Roboy/myoMotorBoard/PCB-POOL_v3.xlsx

BILL OF MATERIAL WITH BETA STOCK, GROUPED BY VALUES, AS OF 09.10.2015
Part | Value | Device | Package | Description | Description2 | Qty | Place_YES/NO | Povided_by_customer_YES/NO | Distributor | Ordernumber | Weblink | Remarks_customer | Unit_price | Total_price | REMARKS_BETA | OPTION1 | OPTION2 | OPTION3
3V3OK, 5VOK, LED5 | Green | LEDCHIPLED_0603 | CHIPLED_0603 | LED |  | 3 | YES | YES | Farnell | 1716770 | http://de.farnell.com/multicomp/ovs-0603/led-0603-super-bright-blau/dp/1716770?ost=1716770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
C1, C2, C3, C6, C7, C8, C9, C14, C16, C17, C18, C19, C24, C25, C30, C31, C36, C56, C57 | 100n | C-EUC0402K | C0402K | CAPACITOR, European symbol | Keramik Kondensator, 0402, X5R, 16V, 100nF | 19 | YES | NO | Beta | 7235228 | http://de.rs-online.com/web/p/ceramic-multilayer-capacitors/7235228P/?searchTerm=7235228p
C4, C5 | 1nF | C-EUC0402K | C0402K | CAPACITOR, European symbol | Kondensator, 0402, X7R, 50V, 1nF | 2 | YES | NO | Beta | 147566 | http://de.rs-online.com/web/p/keramik-multilayer-kondensatoren/0147566/?searchTerm=147566
C10, C12 | 10uF | C-EUC0805K | C0805K | CAPACITOR, European symbol |  | 2 | YES | YES | Farnell | 2611943 | http://de.farnell.com/murata/grm21br6ya106ke43l/kondensator-mlcc-x5r-10uf-35v/dp/2611943?ost=2611943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
C11, C13, C15 | 1uF | C-EUC0603K | C0603K | CAPACITOR, European symbol | Kondensator, 0603, X5R, 16V, 1µF | 3 | YES | NO | Beta | 6911142 | http://de.rs-online.com/web/p/keramik-multilayer-kondensatoren/6911142/?searchTerm=6911142
C22, C23 | 47pf | C-EUC0402K | C0402K | CAPACITOR, European symbol |  | 2 | YES | YES | Farnell | 1758959 | http://de.farnell.com/multicomp/mc0402n470j500ct/kondensator-mlcc-c0g-np0-47pf/dp/1758959?ost=1758959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
C34, C35 | 2.2uF | C-EUC1210 | C1210 | CAPACITOR, European symbol |  | 2 | YES | YES | Farnell | 2320932 | http://de.farnell.com/multicomp/mc1210b225k250ct/kondensator-mlcc-x7r-2-2uf-25v/dp/2320932?ost=2320932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
C50 | 10uF | CPOL-EUD | PANASONIC_D | POLARIZED CAPACITOR, European symbol |  | 1 | YES | YES | Farnell | 2610905 | http://de.farnell.com/multicomp/mcvvt050m100da1l/kond-alu-elko-10uf-50v-becher/dp/2611394
C51, C52, C53, C54 | 10uF | C-EUC1210 | C1210 | CAPACITOR, European symbol |  | 4 | YES | YES | Farnell | 1828859 | http://de.farnell.com/murata/grm32df51h106za01l/kondensator-mlcc-y5v-10uf-50v/dp/1828859?ost=1828859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
C58, C59 | 22uF | C-EUC1210 | C1210 | CAPACITOR, European symbol |  | 2 | YES | YES | Farnell | 2320935 | http://de.farnell.com/multicomp/mc1210x226k250ct/kondensator-mlcc-x5r-22uf-25v/dp/2320935?ost=2320935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
CON2 | IDC 10 | MICRO_MATCH | MIRCO_MATCH |  |  | 1 | YES | YES | Farnell | 1865137 | http://de.farnell.com/amphenol/tmm-6-l-10-1/buchse-smt-lock-1-27mm-10wege/dp/1865137?ost=1865137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
D1, D2, D3 |  | DIODE_2CACA-SOT23 | SOT23 | 2 Diodes - Cathode-Anode|Cathode-Anode |  | 3 | YES | YES | Farnell | 2432680 | http://de.farnell.com/infineon/bat6404e6327htsa1/gr-diode-schottky-0-12a-40v-sot/dp/2432680?ost=2432680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
D5 | RB060MM-60TFTR | 1N5819HW | SOD123 |  |  | 1 | YES | YES | Farnell | 2666946 | http://de.farnell.com/rohm/rb060mm-60tftr/schottky-gleichr-1fach-60v-sod/dp/2666946?ost=2666946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
DC3 | SP6205EM5 | MIC5219BM5 | SOT23-5 | VOLTAGE REGULATOR |  | 1 | YES | YES | RS-Online | 769-5403P | http://de.rs-online.com/web/p/ldo-spannungsregler/7695403P/ | http://de.farnell.com/exar/sp6205em5-l-3-3/spannungsregler-ldo-0-5a-3-3v/dp/9388338?ost=9388338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
DC5 | MAX5035 | MAX5035 | SOIC8 | MAX5035 |  | 1 | YES | YES | Farnell | 2513951 | http://de.farnell.com/webapp/wcs/stores/servlet/ProductDisplay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
J1 | USB | 47346-0001 | MOLEX_47346-0001 | CONN RCPT 5POS MICRO USB R/A SMD |  | 1 | YES | YES | Farnell | 1568026 | http://de.farnell.com/molex/47346-0001/micro-usb-2-0-buchse-typ-b-smd/dp/1568026?ost=1568026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
J3 | TAG Connect | TC2030-MCP-NL | TC2030-MCP-NL | TAG-CONNECT ICSP ConnectorManufacturer: Tag-Connect |  | 1 | NO
L4, L6, L7 | 0603_FERRITE | 0603_FERRITE | R0603 |  |  | 3 | YES | YES | Farnell | 2443234 | http://de.farnell.com/murata/blm18ag121sh1d/ferritperle-0603-0-18ohm-0-5a/dp/2443234?ost=2443234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
L5 | LPS8045B | LPS8045B-104MRB_SPULE | LPS8045B-104MRB_SPULE |  |  | 1 | YES | YES | Farnell | 2526847 | http://de.farnell.com/coilcraft/lps8045b-104mrb/induktivit-t-geschirmt-100uh-1/dp/2526847?ost=2526847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
LED1 | Yellow | LEDCHIPLED_0603 | CHIPLED_0603 | LED |  | 1 | YES | YES | Farnell | 2099227 | http://de.farnell.com/kingbright/kpt-1608yc/led-gelb-0603-smd/dp/2099227?ost=2099227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
LED4 | Red | LEDCHIPLED_0603 | CHIPLED_0603 | LED |  | 1 | YES | YES | Farnell | 2099221 | http://de.farnell.com/kingbright/kpt-1608ec/led-rot-0603-smd/dp/2099221?ost=2099221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
Q1, Q2, Q3, Q4, Q5, Q6 | SI4456DY | SI4456DY | SO8 |  |  | 6 | YES | YES | Farnell | 1792231 | http://de.farnell.com/vishay/si4456dy-t1-e3/n-channel-mosfet-40v-33a-soic/dp/1792231?ost=1792231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
R1, R2, R3, R4, R5, R6, R16, R17 | 10R | R-EU_R0603 | R0603 | RESISTOR, European symbol | RESISTOR, 0.1W, 1% | 8 | YES | No | Beta | 6979084 | http://uk.rs-online.com/web/search/searchBrowseAction.html?method=getProduct&R=6979084
R7, R8 | 0R01 | R-EU_R2512 | R2512 | RESISTOR, European symbol |  | 2 | YES | YES | Farnell | 9403205 | http://de.farnell.com/yageo-phycomp/pf2512fkf7w0r01l/widerstand-2512-2w-r01-1/dp/9403205?ost=9403205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
R10, R11, R12, R22, R33 | 10k | R-EU_R0402 | R0402 | RESISTOR, European symbol | RESISTOR, 0.1W, 1% | 5 | YES | No | Beta | 618-5832 | http://de.rs-online.com/web/p/products/6185832/?searchTerm=618-5832
R13, R28 | 47k | R-EU_R0402 | R0402 | RESISTOR, European symbol | RESISTOR, 0.0625W, 1% | 2 | YES | No | Beta | 6986764 | http://uk.rs-online.com/web/search/searchBrowseAction.html?method=getProduct&R=6986764
R14, R24 | 100k | R-EU_R0402 | R0402 | RESISTOR, European symbol | RESISTOR, 0.0625W, 1% | 2 | YES | No | Beta | 6986783 | http://uk.rs-online.com/web/search/searchBrowseAction.html?method=getProduct&R=6986783
R18 | 470R | R-EU_R0402 | R0402 | RESISTOR, European symbol | RESISTOR, 0.0625W, 1% | 1 | YES | No | Beta | 6980595 | http://uk.rs-online.com/web/search/searchBrowseAction.html?method=getProduct&R=6980595
R20, R26, R27, R31, R55 | 270R | R-EU_R0402 | R0402 | RESISTOR, European symbol | RESISTOR, 0.1W, 1% | 5 | YES | No | Beta | 618-6481 | http://de.rs-online.com/web/p/products/6186481/?searchTerm=618-6481
R21, R25 | 4k7 | R-EU_R0402 | R0402 | RESISTOR, European symbol | RESISTOR, 0.0625W, 1% | 2 | YES | No | Beta | 6980680 | http://uk.rs-online.com/web/search/searchBrowseAction.html?method=getProduct&R=6980680
R23, R29 | 27R | R-EU_R0402 | R0402 | RESISTOR, European symbol | RESISTOR, 0.1W, 1% | 2 | YES | No | Beta | 698-0494 | http://de.rs-online.com/web/p/products/6980494/?searchTerm=698-0494
R50 | 130k | R-EU_R0402 | R0402 | RESISTOR, European symbol |  | 1 | YES | YES | Farnell | 2668197 | http://de.farnell.com/walsin/wr04x1303ftl/dicksch-widerstand-130k-1-0-0625w/dp/2668197?ost=2668197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
R51 | 1M | R-EU_R0402 | R0402 | RESISTOR, European symbol | RESISTOR, 0.0625W, 1% | 1 | YES | No | Beta | 6186194 | http://de.rs-online.com/web/search/searchBrowseAction.html?method=searchProducts&searchTerm=6186194&x=0&y=0
SW1 | TL3700 | TL3700 | TL3700 |  |  | 1 | YES | YES | Farnell | 1894991 | http://de.farnell.com/e-switch/tl3700af160qg/tactile-switch-spst-20ma-15vdc/dp/1894991?ost=1894991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
SW2 | SMD_SWITCH_127_2 | SMD_SWITCH_127_2 | SMD_SWITCH_127_2 |  |  | 1 | YES | YES | Farnell | 1605473 | http://de.farnell.com/multicomp/mcdhn-02f-v/dipschalter-smd-2polig-6-7mm/dp/1605473?ost=1605473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
TVS | SMBJ33A | TVS-DIODE | DIODE |  |  | 1 | YES | YES | Farnell | 9551069 | http://de.farnell.com/vishay/smbj33a-e3-52/tvs-diode-33v-600w-smb/dp/9551069
U$3 | SN65HVD230 | MCP2551 | 999 |  |  | 1 | YES | YES | Farnell | 1103105
U$4 | DSPIC33FJ128MC802QFN | DSPIC33FJ128MC802QFN | QFN-S28-6X6 |  |  | 1 | YES | YES | Farnell | 1576806 | http://de.farnell.com/microchip/dspic33fj128mc802-i-mm/dsc-16bit-128k-flash-40mips-28qfn/dp/1576806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
U$6 | SG-310 | SG-310 | SG-310 |  |  | 1 | YES | YES | Farnell | 1278055 | http://de.farnell.com/epson/q33310f700156-sg-310scf-8-mhz-c/oszillator-spxo-sg-310scf-8mhz/dp/1278055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 | https://www.digikey.de/products/de?keywords=XC1960CT-ND
U1 | A4931 | A4931 | QFN-28-NEW |  |  | 1 | YES | YES | Farnell | 2057410 | http://de.farnell.com/allegro-microsystems/a4931mettr-t/motor-predriver-3ph-28qfn/dp/2057410?ost=2057410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
U2, U3 | MAX3280E | MAX3280E | SOT23-5L |  |  | 2 | YES | YES | Farnell | 2085152 | http://de.farnell.com/maxim-integrated-products/max3280eauk-t/rs422-rs485-rx-52mbps-5-5v-sot23/dp/2512074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
U4 | FT231XQ | FT231XQ | QFN20 |  |  | 1 | YES | YES | Farnell | 2081330 | http://de.farnell.com/ftdi/ft231xq/i-f-usb2-0-fs-f-l-h-s-uart-20qfn/dp/2081330?ost=2081330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
U5, U6 | AD8207 | AD8207 | SO8 |  |  | 2 | YES | YES | Farnell | 1864673 | http://de.farnell.com/analog-devices/ad8207wbrz/ic-amp-diff-hv-8soic/dp/1864673?ost=1864673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
VAR | VC1206K201R025 | VARISTORCN1206 | CT/CN1206 | VARISTOR |  | 1 | YES | YES | Farnell | 2717738 | http://de.farnell.com/kemet/vc1206k201r025/varistor-aec-q200-mlv-65v-1206/dp/2717738
VIN | WAGO_SMD | WAGO_SMD | WAGO_SMD |  |  | 1 | YES | YES | Farnell | 2102477 | http://de.farnell.com/wago/2060-402-998-404/klemmenblock-smd-2pol-24-18awg/dp/2102477?ost=2102477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
X1 | BM06B-SRSS-TB | BM06B-SRSS-TB | BM06B-SRSS-TB | Disconnectable Crimp style connector, 1.0mm pitch6 contacts |  | 1 | YES | YES | Farnell | 1679131 | http://de.farnell.com/jst-japan-solderless-terminals/bm06b-srss-tb-lf-sn/stecker-oben-eing-6kont/dp/1679131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
X2 | BM03B-SRSS-TB | BM03B-SRSS-TB | BM03B-SRSS-TB | Disconnectable Crimp style connector, 1.0mm pitch3 contacts |  | 1 | YES | YES | Farnell | 1679128 | http://de.farnell.com/jst-japan-solderless-terminals/bm03b-srss-tb-lf-sn/stecker-oben-eing-3kont/dp/1679128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
X4 | BM05B-SRSS-TB | BM05B-SRSS-TB | BM05B-SRSS-TB | Disconnectable Crimp style connector, 1.0mm pitch5 contacts |  | 1 | YES | YES | Farnell | 1679130 | http://de.farnell.com/jst-japan-solderless-terminals/bm05b-srss-tb-lf-sn/stecker-oben-eing-5kont/dp/1679130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
X5 | MKS1650-8 | MKS1650-8 | MKS1650 |  |  | 1 | NO
