Roboy/myoMotorBoard/motor drive 8y_protection.pdf

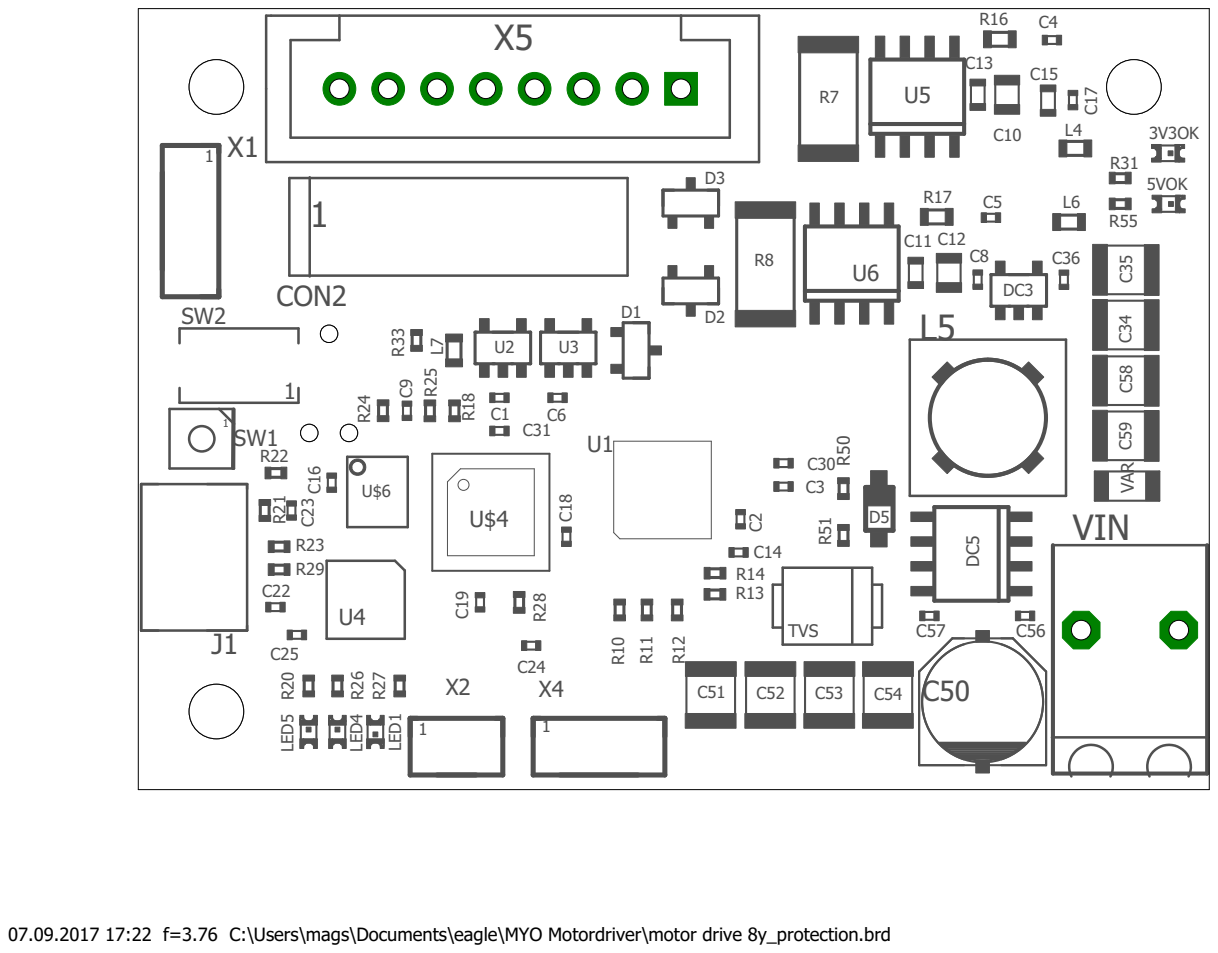
[picture p1: page 1]

07.09.2017 17:22 f=3.76 C:\Users\mags\Documents\eagle\MYO Motordriver\motor drive 8y_protection.brd
