Roboy/myoMotorBoard/motor drive 8y_top.pdf

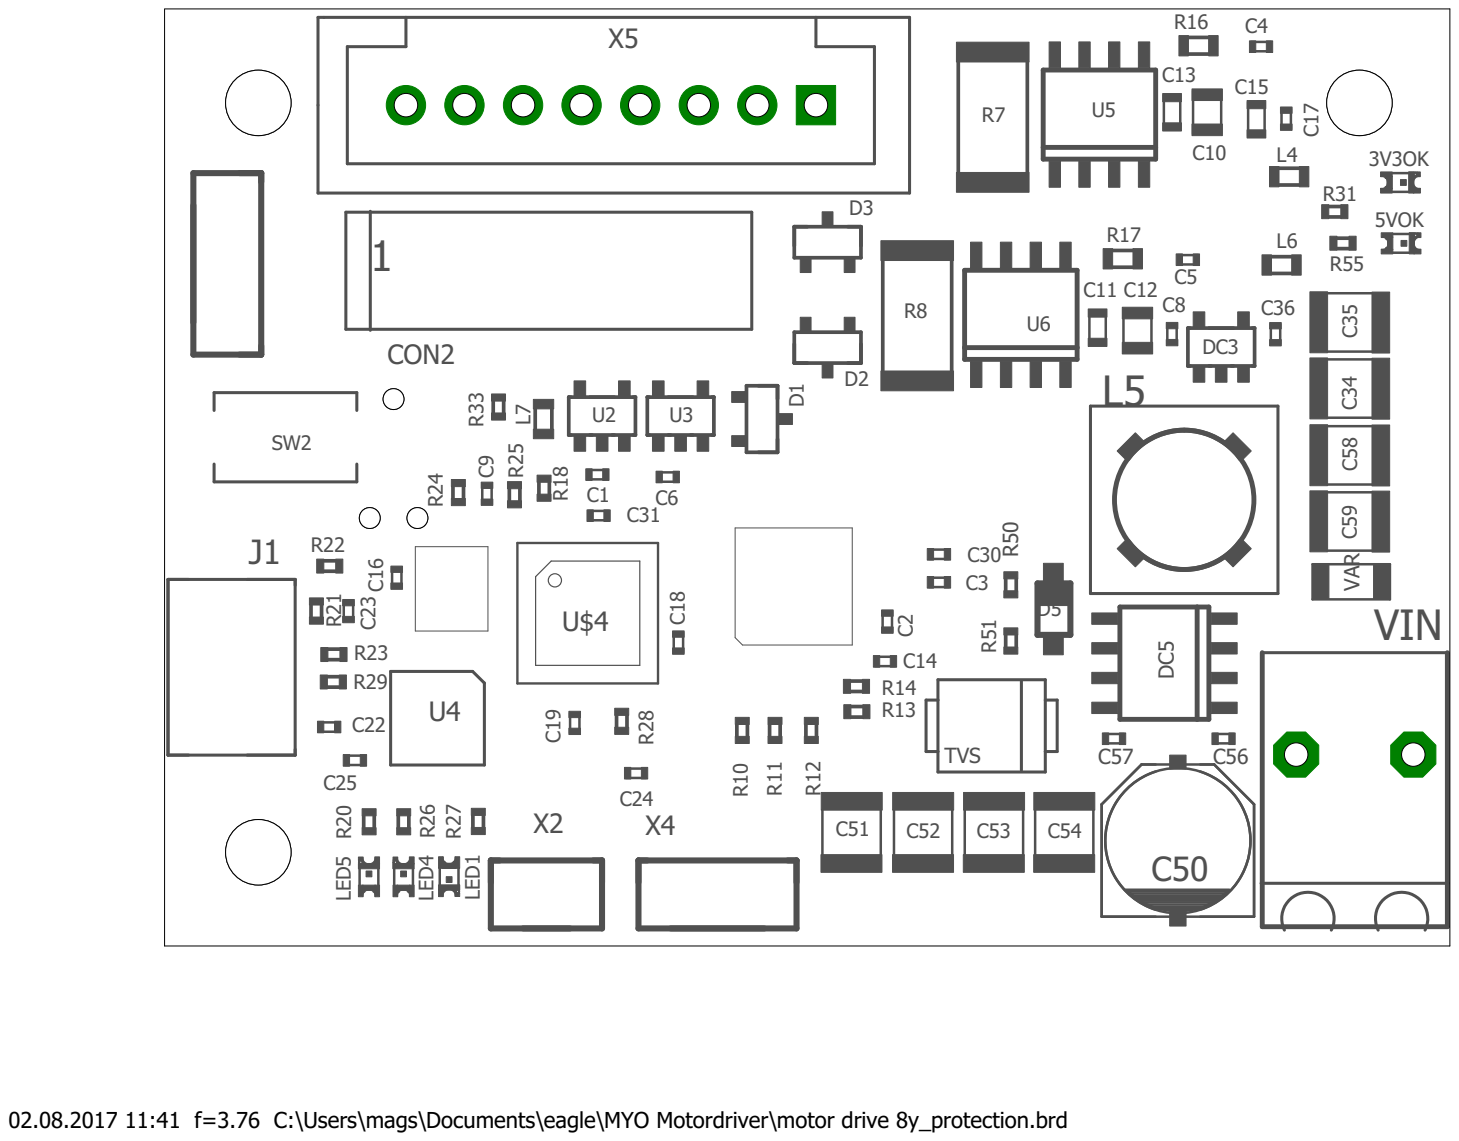
[picture p2: page 1]

02.08.2017 11:41 f=3.76 C:\Users\mags\Documents\eagle\MYO Motordriver\motor drive 8y_protection.brd
