Roboy/myoMotorBoard/motor drive 9y_bottom.pdf

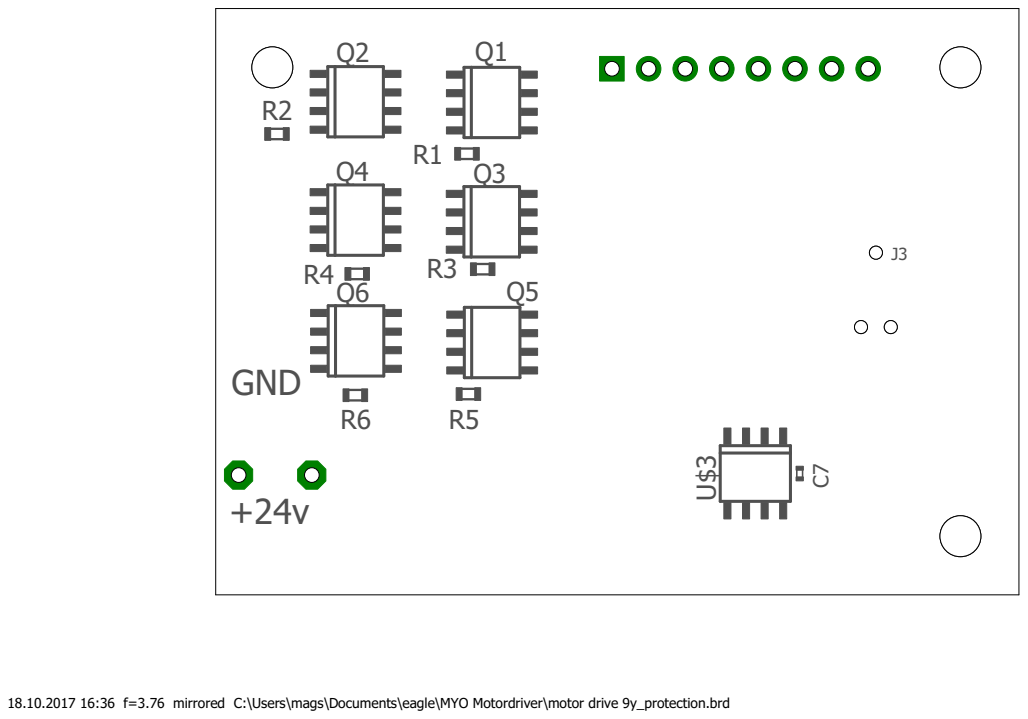
[picture p3: page 1]

18.10.2017 16:36 f=3.76 mirrored C:\Users\mags\Documents\eagle\MYO Motordriver\motor drive 9y_protection.brd
