Roboy/myoMotorBoard/motor drive 9y_top.pdf

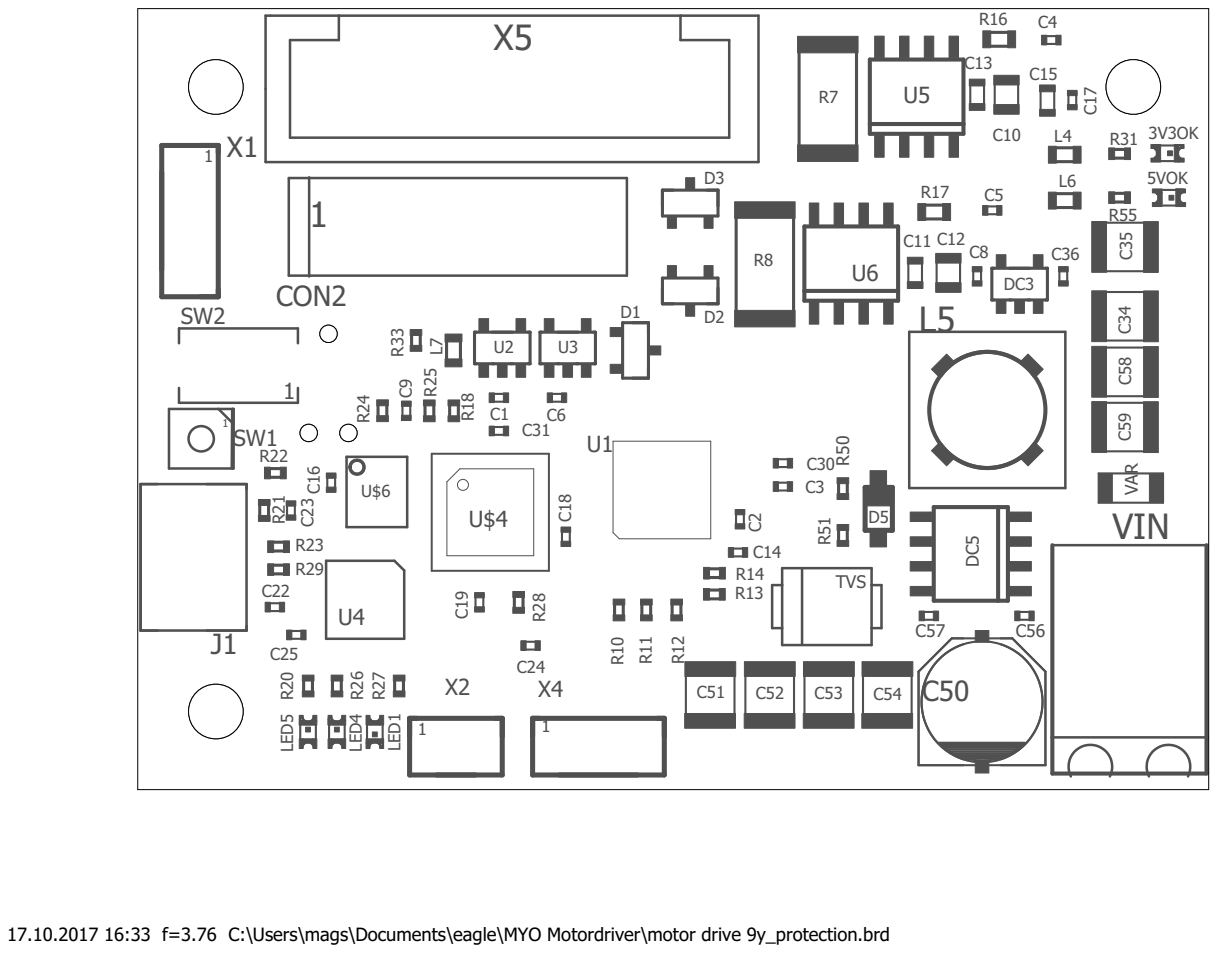
[picture p4: page 1]

17.10.2017 16:33 f=3.76 C:\Users\mags\Documents\eagle\MYO Motordriver\motor drive 9y_protection.brd
