Roboy/myoMotorBoard/motor drive 6_protection.brd

## EAGLE design motor drive 6_protection.brd (2019-08-27)

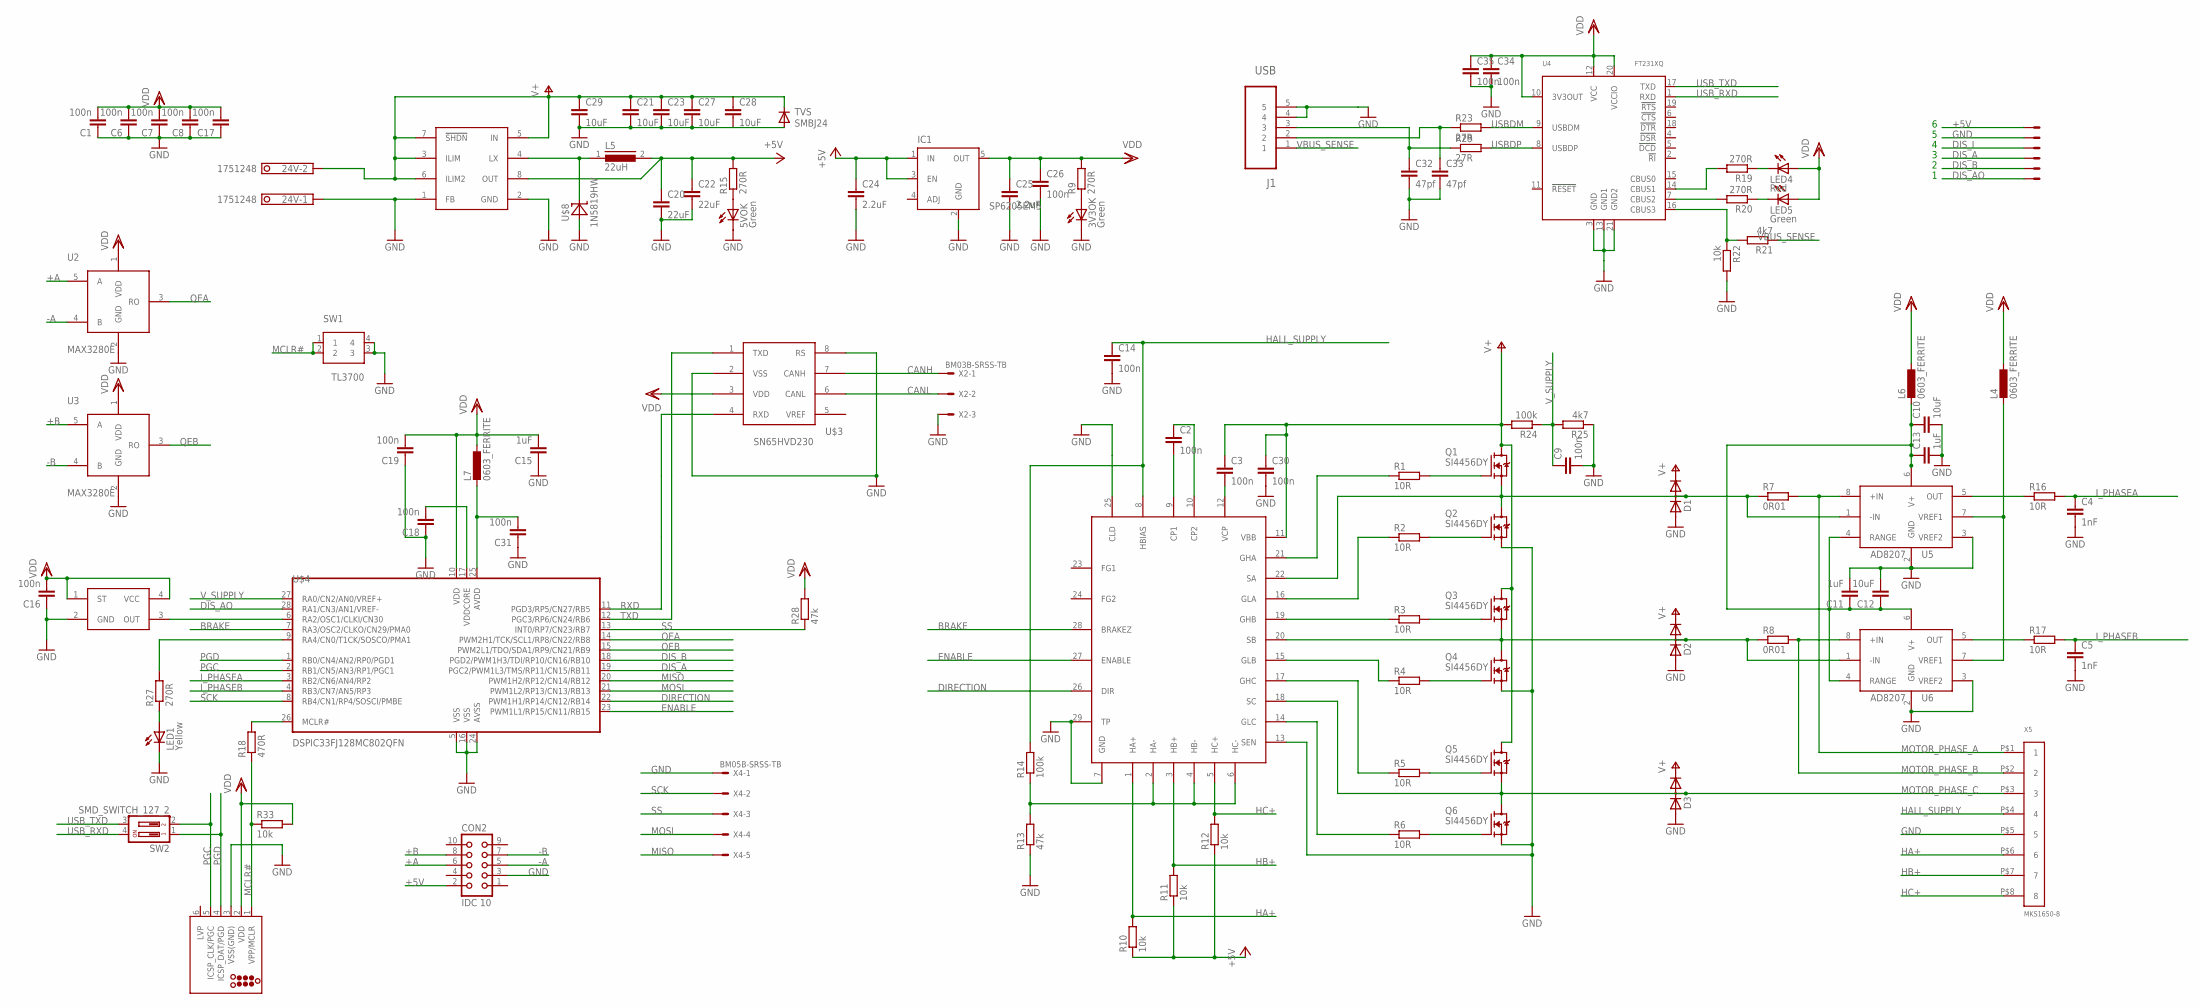
[picture p8: schematic motor drive 6_protection.sch, sheet 1]

Parts:
3V3OK, 5VOK: Green; CHIPLED_0603
24V: 1751248
C1, C2, C3, C6, C7, C8, C9, C14, C16, C17, C18, C19, C26, C30, C31, C34, C35: 100n; C0402K
C4, C5: 1nF; C0402K
C10, C12: 10uF; C0805K
C11, C13, C15: 1uF; C0603K
C20, C22: 22uF; C1210
C21, C23, C27, C28, C29: 10uF; C1210
C24, C25: 2.2uF; C1210
C32, C33: 47pf; C0402K
CON2: IDC 10; CON10
D1, D2, D3: DIODE_2CACA-SOT23; SOT23
IC1: SP6205EM5; SOT23-5
J1: USB; MOLEX_47346-0001
J3: TAG Connect; TC2030-MCP-NL
L4, L6, L7: 0603_FERRITE; R0603
L5: 22uH; DR73
LED1: Yellow; CHIPLED_0603
LED4: Red; CHIPLED_0603
LED5: Green; CHIPLED_0603
Q1, Q2, Q3, Q4, Q5, Q6: SI4456DY; SO8
R1, R2, R3, R4, R5, R6, R16, R17: 10R; R0603
R7, R8: 0R01; R2512
R9, R15, R19, R20, R27: 270R; R0402
R10, R11, R12, R22, R33: 10k; R0402
R13, R28: 47k; R0402
R14, R24: 100k; R0402
R18: 470R; R0402
R21, R25: 4k7; R0402
R23, R29: 27R; R0402
SW1: TL3700
SW2: SMD_SWITCH_127_2
TVS: SMBJ24; SOD-123_MINI-SMA
U1: A4931; QFN-28-NEW
U2, U3: MAX3280E; SOT23-5L
U4: FT231XQ; QFN20
U5, U6: AD8207; SO8
U$3: SN65HVD230; 999
U$4: DSPIC33FJ128MC802QFN; QFN-S28-6X6
U$5: MAX1776; UMAX8
U$6: SG-310
U$8: 1N5819HW; SOD123
X1: BM06B-SRSS-TB
X2: BM03B-SRSS-TB
X4: BM05B-SRSS-TB
X5: MKS1650-8; MKS1650

Connections:
+5V: C20.1, C22.1, C24.1, CON2.2, IC1.1 (IN), IC1.3 (EN), L5.2, R10.1, R11.1, R12.1, R15.2, U$5.8 (OUT), X1.1
+A: CON2.6, U2.5 (A)
+B: CON2.8, U3.5 (A)
-A: CON2.5, U2.4 (B)
-B: CON2.7, U3.4 (B)
BRAKE: U1.28 (BRAKEZ), U$4.7 (RA3/OSC2/CLKO/CN29/PMA0)
CANH: U$3.7 (CANH), X2.1
CANL: U$3.6 (CANL), X2.2
DIRECTION: U1.26 (DIR), U$4.22 (PWM1H1/RP14/CN12/RB14)
DIS_A: U$4.19 (PGC2/PWM1L3/TMS/RP11/CN15/RB11), X1.4
DIS_AO: U$4.28 (RA1/CN3/AN1/VREF-), X1.6
DIS_B: U$4.18 (PGD2/PWM1H3/TDI/RP10/CN16/RB10), X1.5
DIS_I: X1.3
ENABLE: U1.27 (ENABLE), U$4.23 (PWM1L1/RP15/CN11/RB15)
GND: 3V3OK.C, 5VOK.C, 24V.1, C1.1, C4.2, C5.2, C6.1, C7.1, C8.1, C9.2, C10.2, C11.2, C12.2, C13.2, C14.2, C15.1, C16.1, C17.1, C18.1, C19.1, C20.2, C21.2, C22.2, C23.2, C24.2, C25.2, C26.2, C27.2, C28.2, C29.2, C30.2, C31.1, C32.2, C33.2, C34.2, C35.2, CON2.3, D1.1 (A), D2.1 (A), D3.1 (A), IC1.2 (GND), J1.4, J1.5, J3.3 (VSS(GND)), LED1.C, Q2.1 (S), Q2.2 (S), Q2.3 (S), Q4.1 (S), Q4.2 (S), Q4.3 (S), Q6.1 (S), Q6.2 (S), Q6.3 (S), R13.1, R22.2, R25.1, SW1.3, SW1.4, TVS.A, U1.7 (GND), U1.13 (SEN), U1.25 (CLD), U1.29 (TP), U2.2 (GND), U3.2 (GND), U4.3 (GND), U4.13 (GND1), U4.21 (GND2), U5.2 (GND), U5.3 (VREF2), U6.2 (GND), U6.3 (VREF2), U$3.2 (VSS), U$3.8 (RS), U$4.5 (VSS), U$4.16 (VSS), U$4.24 (AVSS), U$5.1 (FB), U$5.2 (GND), U$6.2 (GND), U$8.A, X1.2, X2.3, X4.1, X5.P$5 (5); also elsewhere on the board
HA+: R10.2, U1.1 (HA+), X5.P$6 (6)
HALL_SUPPLY: C14.1, R14.2, U1.8 (HBIAS), X5.P$4 (4)
HB+: R11.2, U1.3 (HB+), X5.P$7 (7)
HC+: R12.2, U1.5 (HC+), X5.P$8 (8)
I_PHASEA: C4.1, R16.2, U$4.3 (RB2/CN6/AN4/RP2)
I_PHASEB: C5.1, R17.2, U$4.4 (RB3/CN7/AN5/RP3)
MCLR#: J3.1 (VPP/MCLR), R18.1, R33.1, SW1.1, SW1.2
MISO: U$4.20 (PWM1H2/RP12/CN14/RB12), X4.5
MOSI: U$4.21 (PWM1L2/RP13/CN13/RB13), X4.4
MOTOR_PHASE_A: R7.2, U5.8 (+IN), X5.P$1 (1)
MOTOR_PHASE_B: R8.2, U6.8 (+IN), X5.P$2 (2)
MOTOR_PHASE_C: D3.3 (AC), Q5.1 (S), Q5.2 (S), Q5.3 (S), Q6.5 (D), Q6.6 (D), Q6.7 (D), Q6.8 (D), U1.18 (SC), X5.P$3 (3)
unnamed: Q1.4 (G), R1.2
unnamed: Q2.4 (G), R2.2
unnamed: Q3.4 (G), R3.2
unnamed: Q4.4 (G), R4.2
unnamed: Q5.4 (G), R5.2
unnamed: Q6.4 (G), R6.2
unnamed: 5VOK.A, R15.1
unnamed: R1.1, U1.21 (GHA)
unnamed: R2.1, U1.16 (GLA)
unnamed: R3.1, U1.19 (GHB)
unnamed: R4.1, U1.15 (GLB)
unnamed: R5.1, U1.17 (GHC)
unnamed: R6.1, U1.14 (GLC)
unnamed: C10.1, C11.1, C12.1, C13.1, L6.2, U5.4 (RANGE), U5.6 (V+), U6.4 (RANGE), U6.6 (V+)
unnamed: 3V3OK.A, R9.1
unnamed: LED4.C, R19.1
unnamed: U$4.6 (RA2/OSC1/CLKI/CN30), U$6.3 (OUT)
unnamed: L4.2, U5.7 (VREF1), U6.7 (VREF1)
unnamed: R18.2, U$4.26 (MCLR#)
unnamed: LED5.C, R20.1
unnamed: LED1.A, R27.1
unnamed: C18.2, U$4.17 (VDDCORE)
unnamed: R13.2, R14.1, U1.2 (HA-), U1.4 (HB-), U1.6 (HC-)
unnamed: R27.2, U$4.9 (RA4/CN0/T1CK/SOSCO/PMA1)
unnamed: R20.2, U4.7 (CBUS2)
unnamed: R19.2, U4.14 (CBUS1)
unnamed: C33.1, J1.2, R23.1
unnamed: L5.1, U$5.4 (LX), U$8.C
unnamed: R21.2, R22.1, U4.16 (CBUS3)
unnamed: C2.2, U1.9 (CP1)
unnamed: C2.1, U1.10 (CP2)
unnamed: C3.2, U1.12 (VCP)
unnamed: C32.1, J1.3, R29.1
unnamed: C31.2, L7.2, U$4.25 (AVDD)
PGC: J3.5 (ICSP_CLK/PGC), SW2.2, U$4.2 (RB1/CN5/AN3/RP1/PGC1)
PGD: J3.4 (ICSP_DAT/PGD), SW2.1, U$4.1 (RB0/CN4/AN2/RP0/PGD1)
PHASE_A: R16.1, U5.5 (OUT)
PHASE_B: R17.1, U6.5 (OUT)
QEA: U2.3 (RO), U$4.14 (PWM2H1/TCK/SCL1/RP8/CN22/RB8)
QEB: U3.3 (RO), U$4.15 (PWM2L1/TDO/SDA1/RP9/CN21/RB9)
RXD: U$3.4 (RXD), U$4.11 (PGD3/RP5/CN27/RB5)
SA: D1.3 (AC), Q1.1 (S), Q1.2 (S), Q1.3 (S), Q2.5 (D), Q2.6 (D), Q2.7 (D), Q2.8 (D), R7.1, U1.22 (SA), U5.1 (-IN)
SB: D2.3 (AC), Q3.1 (S), Q3.2 (S), Q3.3 (S), Q4.5 (D), Q4.6 (D), Q4.7 (D), Q4.8 (D), R8.1, U1.20 (SB), U6.1 (-IN)
SCK: U$4.8 (RB4/CN1/RP4/SOSCI/PMBE), X4.2
SS: R28.1, U$4.13 (INT0/RP7/CN23/RB7), X4.3
TXD: U$3.1 (TXD), U$4.12 (PGC3/RP6/CN24/RB6)
USBDM: R23.2, U4.9 (USBDM)
USBDP: R29.2, U4.8 (USBDP)
USB_RXD: SW2.4, U4.1 (RXD)
USB_TXD: SW2.3, U4.17 (TXD)
V+: 24V.2, C3.1, C21.1, C23.1, C27.1, C28.1, C29.1, C30.1, D1.2 (C), D2.2 (C), D3.2 (C), Q1.5 (D), Q1.6 (D), Q1.7 (D), Q1.8 (D), Q3.5 (D), Q3.6 (D), Q3.7 (D), Q3.8 (D), Q5.5 (D), Q5.6 (D), Q5.7 (D), Q5.8 (D), R24.2, TVS.C, U1.11 (VBB), U$5.3 (ILIM), U$5.5 (IN), U$5.6 (ILIM2), U$5.7 (!SHDN)
VBUS_SENSE: J1.1, R21.1
VDD: C1.2, C6.2, C7.2, C8.2, C15.2, C16.2, C17.2, C19.2, C25.1, C26.1, C34.1, C35.1, IC1.5 (OUT), J3.2 (VDD), L4.1, L6.1, L7.1, LED4.A, LED5.A, R9.2, R28.2, R33.2, U2.1 (VDD), U3.1 (VDD), U4.10 (3V3OUT), U4.12 (VCC), U4.20 (VCCIO), U$3.3 (VDD), U$4.10 (VDD), U$6.1 (ST), U$6.4 (VCC)
V_SUPPLY: C9.1, R24.1, R25.2, U$4.27 (RA0/CN2/AN0/VREF+)

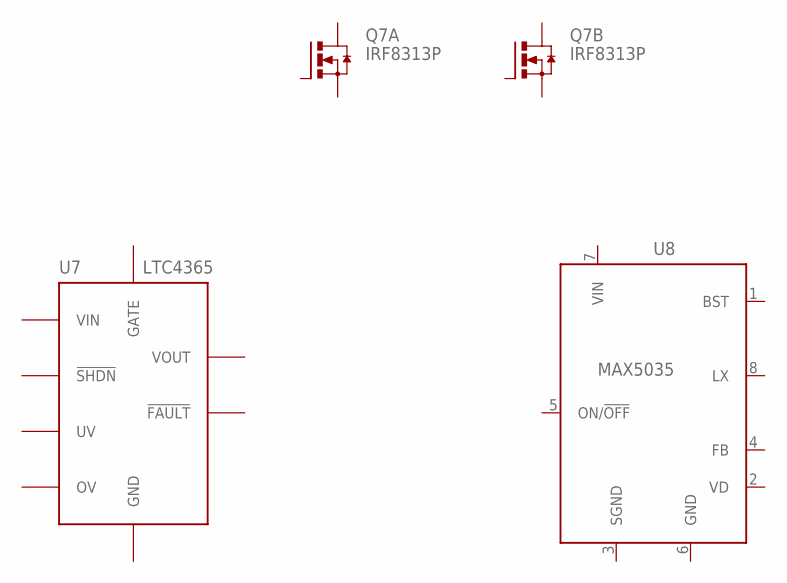
[picture p9: schematic motor drive 6_protection.sch, sheet 2]

Parts:
Q7: IRF8313P; SO-08
U7: LTC4365; TSOT-23-8
U8: MAX5035; SOIC8

Connections:
GND: U7.4 (GND), U8.6 (GND); also elsewhere on the board
SGND: U8.3 (SGND)
VIN: U8.7 (VIN)
VOUT: U7.7 (VOUT)

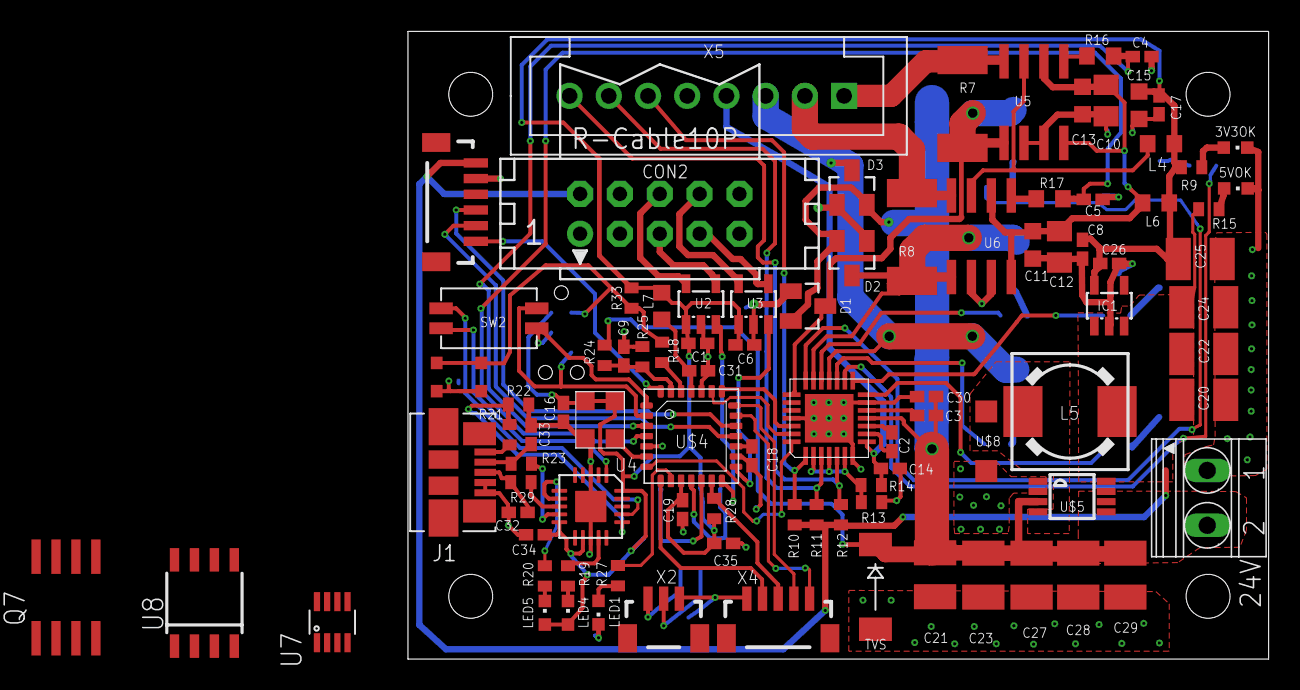
[picture p10: board motor drive 6_protection.brd from above]

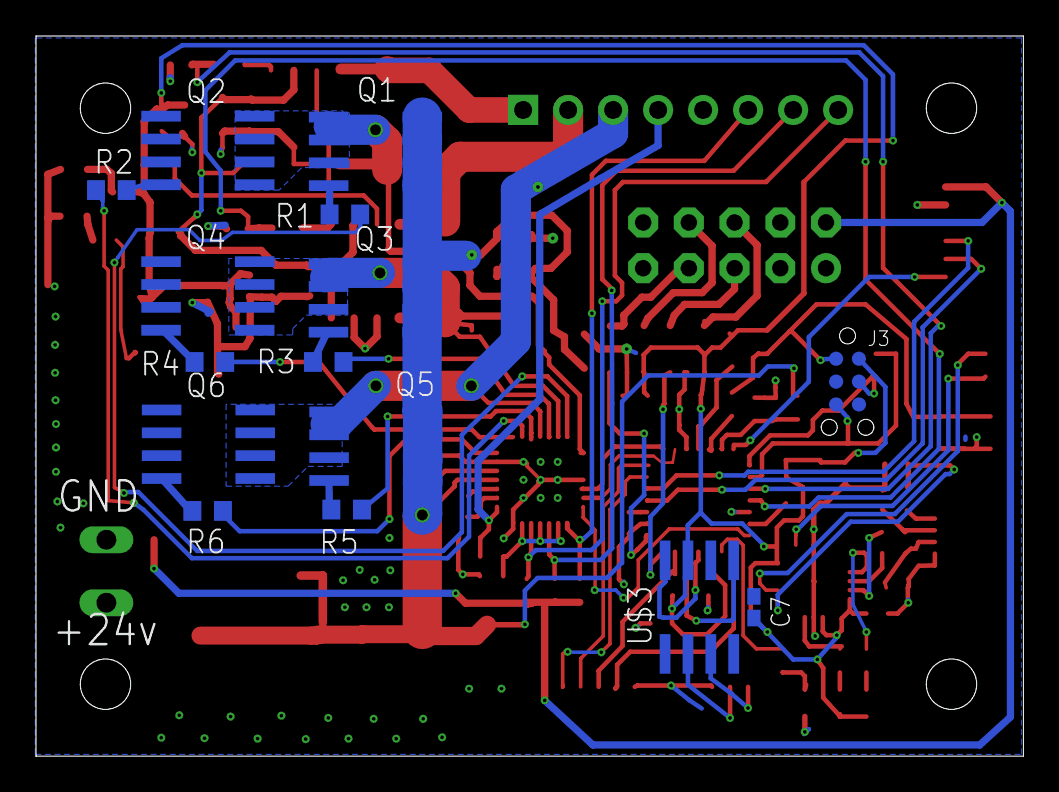
[picture p11: board motor drive 6_protection.brd from below]

Board: 2 copper layers, 54.9 x 40.0 mm, 108 parts (15 on the bottom side), 80 nets.
