Roboy/myoMotorBoard/(notices)

Notices in the files:
parts and their libraries:
tag-connect: ©2009 ROFA.cz - modified and updated by Robert Darlington ‹rdarlington@gmail.com›
Volks73-LinearTechnology: Creative Commons Attribution-ShareAlike 3.0 Unported (CC BY-SA 3.0), http://creativecommons.org/licenses/by-sa/3.0/.
